Edzelf/ESP-IR/data/samsungtv.jpg

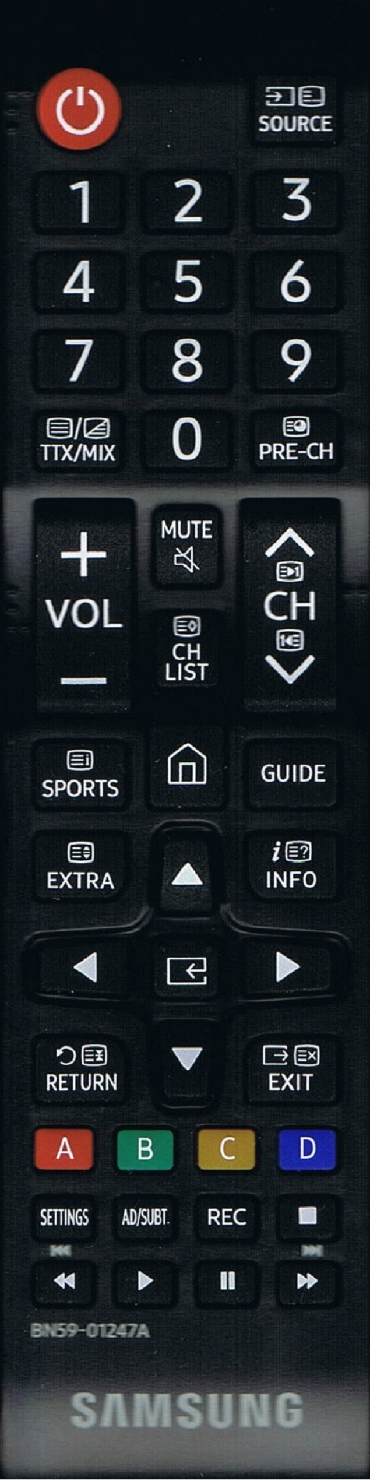
data/samsungtv.jpg
