Edzelf/ESP-IR/data/lg.jpg

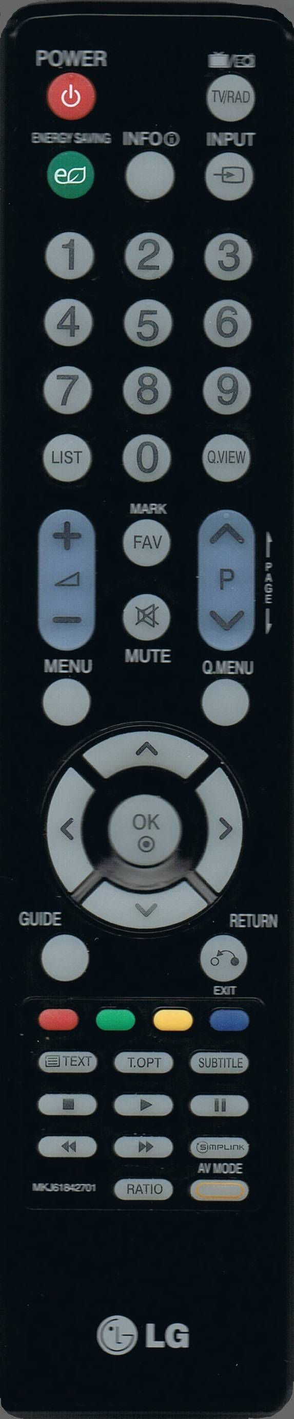
data/lg.jpg
