Edzelf/ESP-IR/data/itv.jpg

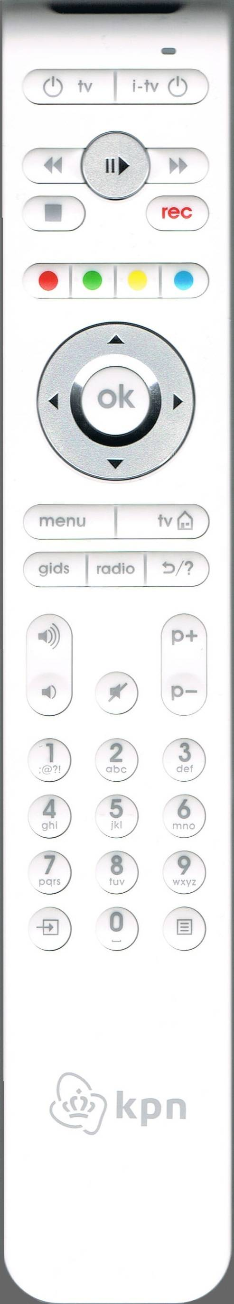
data/itv.jpg
