Edzelf/ESP-IR/data/samsung.jpg

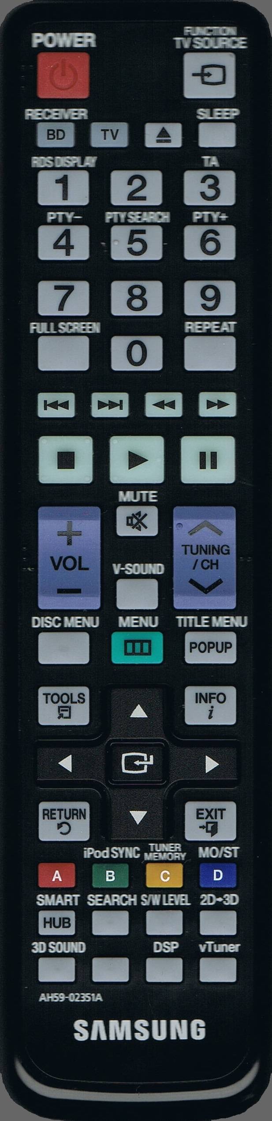
data/samsung.jpg
